mkultr44/VT-AMP/README.md

# **860 MHz - 960 MHz RX / TX Amplifier**

### Specs

RX / TX Gain 19.8 dB

0.45 dB Noise Figure

TX sense adjustable from -16 dBm to +22 dBm

Supply VIN 6V via coax

### Indicators

Indicator | Function
--------- | --------
VIN | Coax input voltage is present
5V | 5 V LDO operational
3V3 | 3.3 V LDO operational
RX | Amplifier in receive mode
TX | Amplifier in transmit mode
MCU | Microcontroller is operational
BC | Starts blinking if transmit mode got activated at least once, on continous if transmit mode got activated at least 5 times

### Threshold

Adjust TX threshold via trimmer, LED bar shows approximate dBm value, more precise output is possible via USB connection to serial port
### PCB Stack Up

Layer | Material | Thickness (mil) | Thickness (mm)
----- | -------- | --------------- | --------------
L1 | Outer Copper Weight 1 oz | 1.38 | 0.0350
Prepreg | 7628, RC 49%, 8.6 mil | 8.28 | 0.2104
L2 | Inner Copper Weight 0.5 oz | 0.6 | 0.0152
Core | 0.4mm H/HOZ without copper | 15.75 | 0.4
L3 | Inner Copper Weight 0.5 oz | 0.6 | 0.0152
Prepreg | 7628, RC 49%, 8.6 mil | 8.28 | 0.2104
L4 | Inner Copper Weight 0.5 oz | 0.6 | 0.0152
Core | 0.4mm H/HOZ without copper | 15.75 | 0.4
L5 | Inner Copper Weight 0.5 oz | 0.6 | 0.0152
Prepreg | 7628, RC 49%, 8.6 mil | 8.28 | 0.2104
L6 | Outer Copper Weight 1 oz | 1.38 | 0.0350

### Flashing Firmware

Connect via USB-C to PC while pressing boot button, device shows up as external flash drive, drop .uf2 file to drive. Done.

## Pictures and Renders




nanovna-h4_2024-10-08_07-15-48
PCB_TQP_2024-10-10_1_copy_3
PCB_TQP_2024-10-10_2_copy_3
PCB_TQP_2024-10-10_3_copy_3
PCB_TQP_2024-10-10_4_copy_3
PCB_TQP_2024-10-10_5_copy_3
PCB_TQP_2024-10-10_6_copy_3
3D_TQP_2024-10-13-top
3D_TQP_2024-10-13-bot
