mkultr44/VT-AMP/(commit log)

2024-08-30 upload manufacturing data
    [Drill_NPTH_Through.DRL, Drill_PTH_Through.DRL, Drill_PTH_Through_Via.DRL, Gerber_BoardOutlineLayer.GKO, Gerber_BottomLayer.GBL, Gerber_BottomPasteMaskLayer.GBP, Gerber_BottomSilkscreenLayer.GBO, Gerber_BottomSolderMaskLayer.GBS]
2024-09-01 changed bunch of stuff
    [Drill_NPTH_Through.DRL, Drill_PTH_Through.DRL, Drill_PTH_Through_Via.DRL, Gerber_BoardOutlineLayer.GKO, Gerber_BottomLayer.GBL, Gerber_BottomPasteMaskLayer.GBP, Gerber_BottomSilkscreenLayer.GBO, Gerber_BottomSolderMaskLayer.GBS]
2024-09-01 going on
    [shell-b.step, shell-t.step]
2024-09-01 BOM to manufacturing
    [BOM_VT-AMP.CSV]
2024-09-01 Update BOM_VT-AMP.CSV
    corrected quantities
    [BOM_VT-AMP.CSV]
2024-09-01 Update BOM_VT-AMP.CSV
    minor corrections
    [BOM_VT-AMP.CSV]
2024-09-08 changed csv to international formating
    [BOM.CSV, BOM_EN.CSV]
2024-09-22 bom update
    [BOM.CSV, BOM_EN.CSV]
2024-10-10 Add GERBERS
    [Drill_NPTH_Through.DRL, Drill_PTH_Through.DRL, Drill_PTH_Through_Via.DRL, Gerber_BoardOutlineLayer.GKO, Gerber_BottomLayer.GBL, Gerber_BottomPasteMaskLayer.GBP, Gerber_BottomSilkscreenLayer.GBO, Gerber_BottomSolderMaskLayer.GBS]
2024-10-13 update gerbers
    [Drill_NPTH_Through.DRL, Drill_PTH_Through.DRL, Drill_PTH_Through_Via.DRL, Gerber_BoardOutlineLayer.GKO, Gerber_BottomLayer.GBL, Gerber_BottomPasteMaskLayer.GBP, Gerber_BottomSilkscreenLayer.GBO, Gerber_BottomSolderMaskLayer.GBS]
